borhencherni/Humanoid-Robotic-Arm/Mécanique/7.png

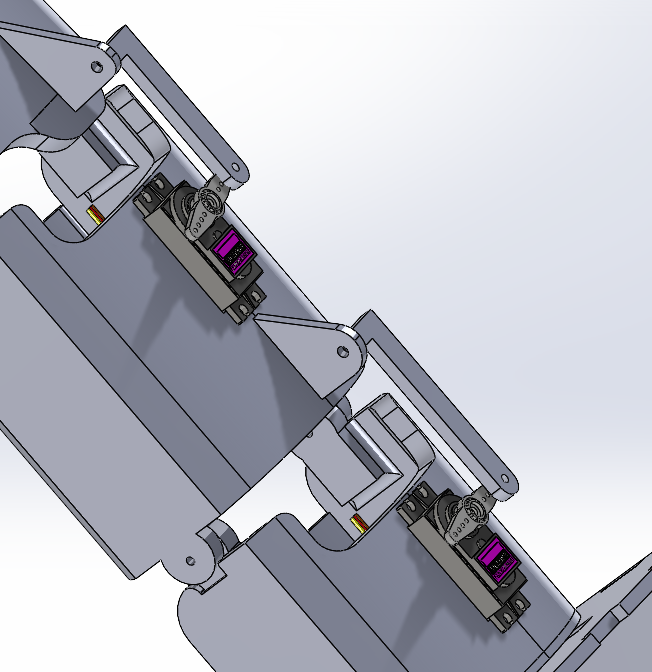
Mécanique/7.png
