borhencherni/Humanoid-Robotic-Arm/Mécanique/3.png

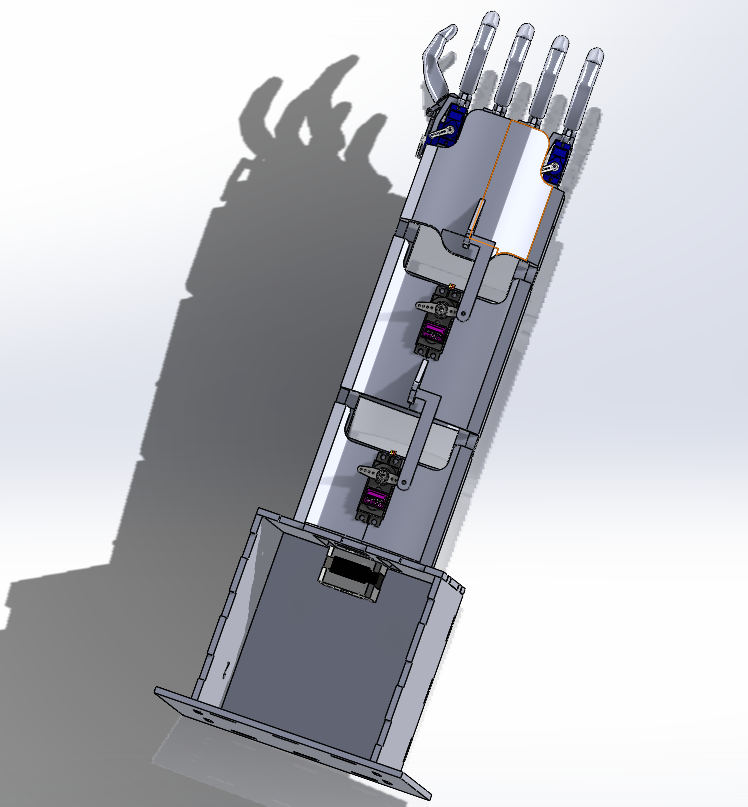
Mécanique/3.png
