borhencherni/Humanoid-Robotic-Arm/Electronique/4.png

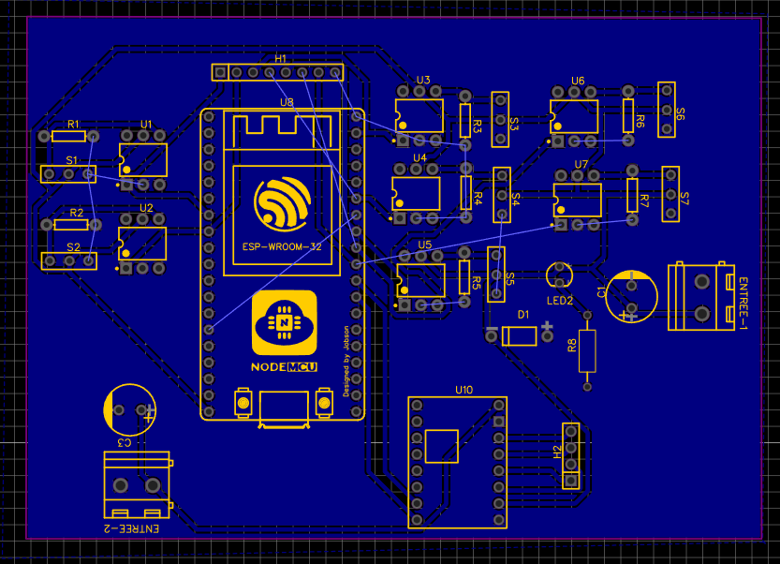
Electronique/4.png
