borhencherni/Humanoid-Robotic-Arm/Electronique/PCB_PCB_carte-ppp-finale_2025-05-31.png

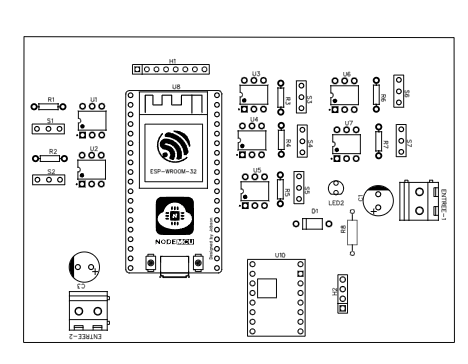
Electronique/PCB_PCB_carte-ppp-finale_2025-05-31.png
