borhencherni/Humanoid-Robotic-Arm/Mécanique/1.png

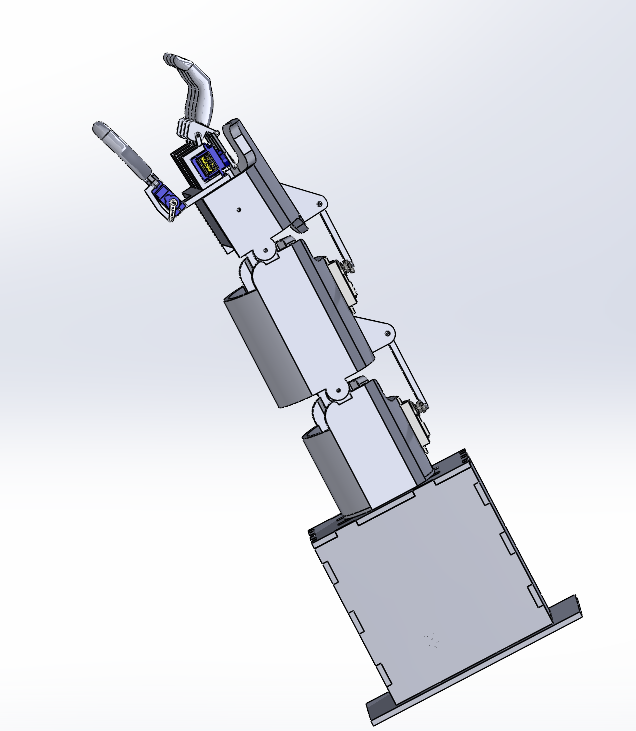
Mécanique/1.png
