borhencherni/Humanoid-Robotic-Arm/Mécanique/2.png

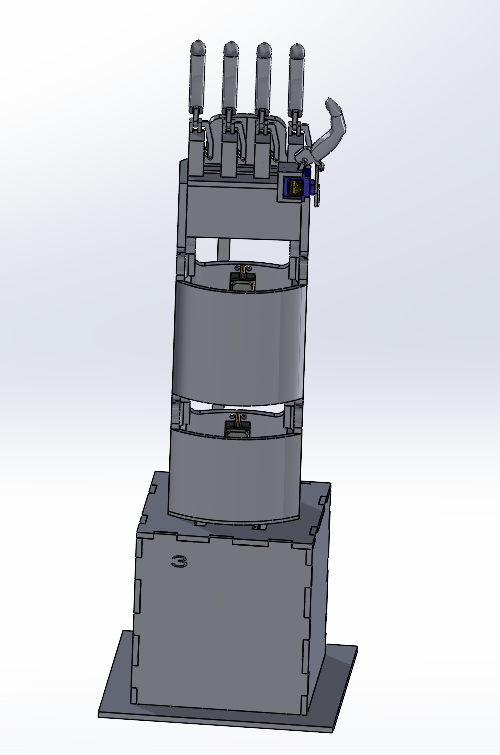
Mécanique/2.png
