borhencherni/Humanoid-Robotic-Arm/Mécanique/5.png

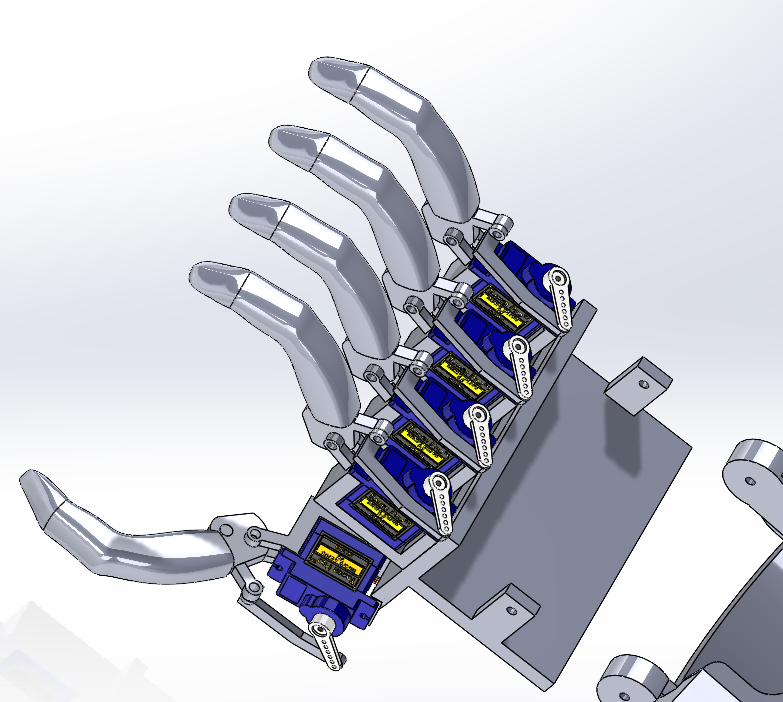
Mécanique/5.png
