borhencherni/Humanoid-Robotic-Arm/Mécanique/6.png

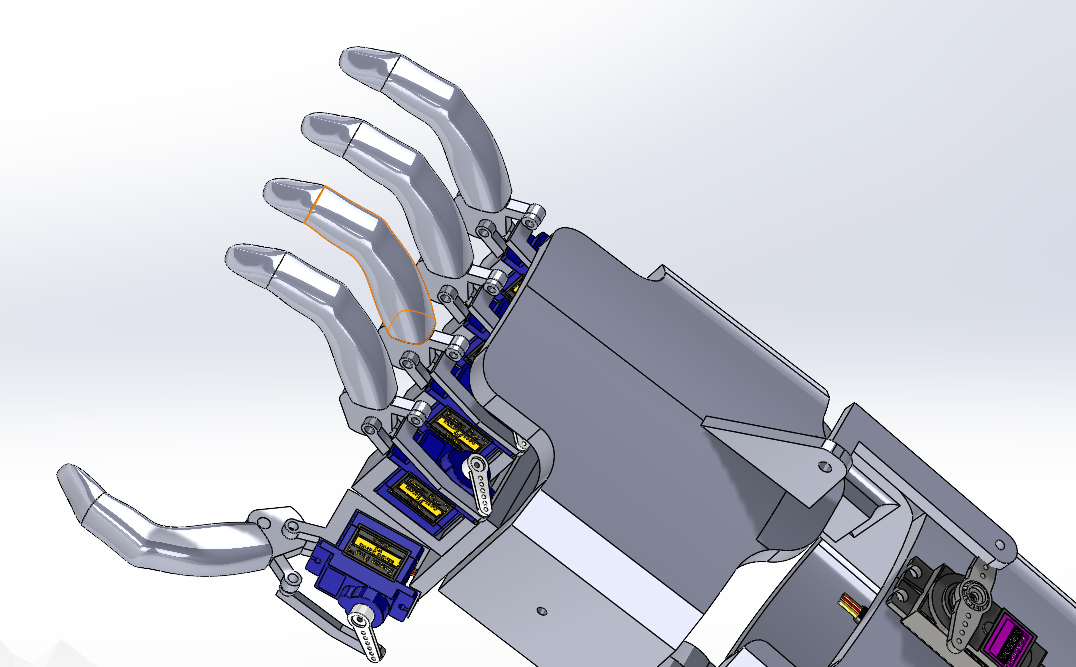
Mécanique/6.png
