borhencherni/Humanoid-Robotic-Arm/Mécanique/assemyed.SLDASM

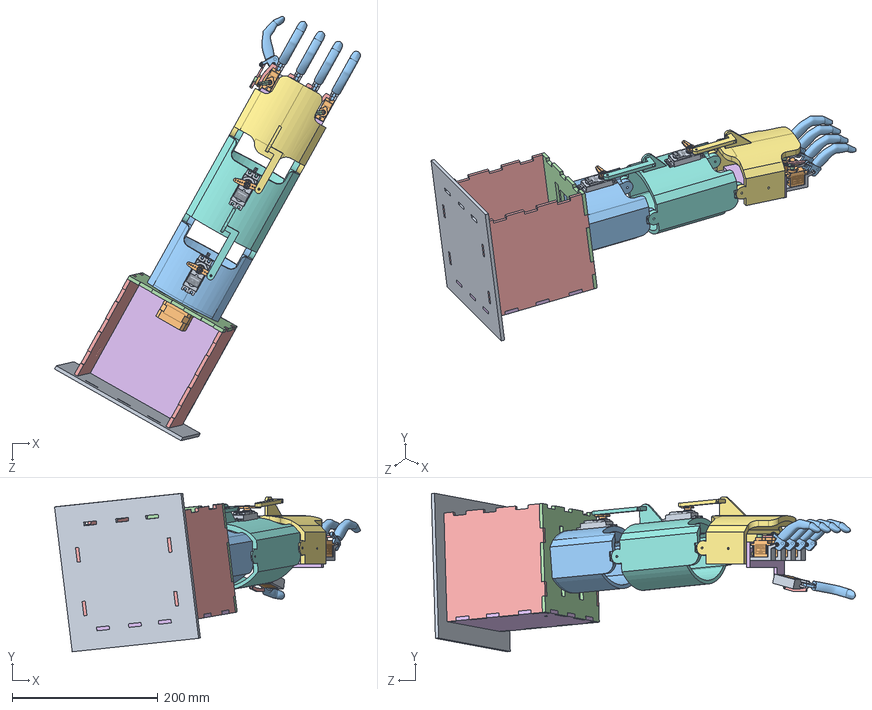
[picture p32: CAD file, 2025-06-15]
Mécanique/assemyed.SLDASM
419.3 x 217.3 x 581.5 mm
support servo x 5
SG90 - Micro Servo 9g - Tower Pro.1 x 5
sboo3 x 5
SG90 - Micro Servo 9g - Tower Pro.2 x 5
sbo3servo x 5
kaff
cagefou9
chtar yed
mg996R_v2.step x 2
mg996_arm_2pad.step x 2
chtar theni
liaison1
liaison2
Stepper motor Nema 17 (17HS2408).step
