borhencherni/Humanoid-Robotic-Arm/Mécanique/Assemsbo3.SLDASM

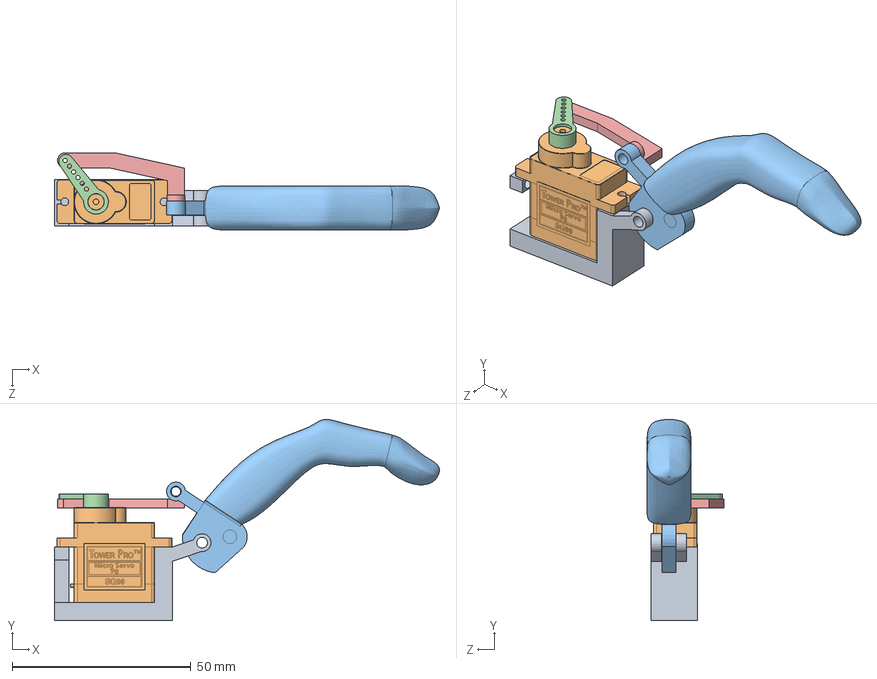
[picture p34: CAD file, 2025-06-15]
Mécanique/Assemsbo3.SLDASM
107.7 x 56.3 x 21.6 mm
support servo
SG90 - Micro Servo 9g - Tower Pro.1
sboo3
SG90 - Micro Servo 9g - Tower Pro.2
sbo3servo
