borhencherni/Humanoid-Robotic-Arm/Mécanique/mg996_arm_2pad.step

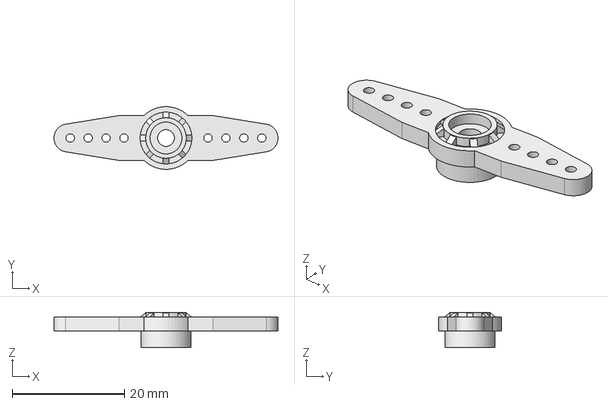
[picture p35: CAD file, 2025-06-15]
Mécanique/mg996_arm_2pad.step
40.0 x 11.2 x 6.30 mm
