borhencherni/Humanoid-Robotic-Arm/Mécanique/1.SLDPRT

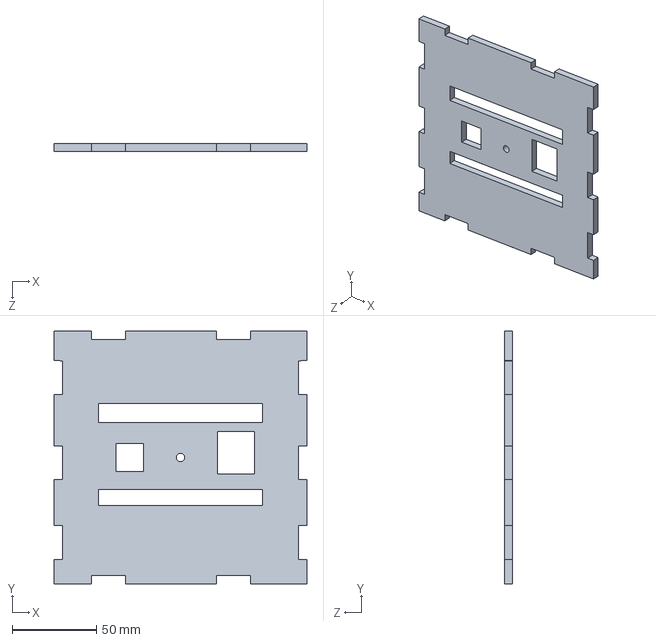
[picture p36: CAD file, 2025-06-15]
Mécanique/1.SLDPRT
150.0 x 150.0 x 5.00 mm
