borhencherni/Humanoid-Robotic-Arm/Mécanique/kaff.SLDPRT

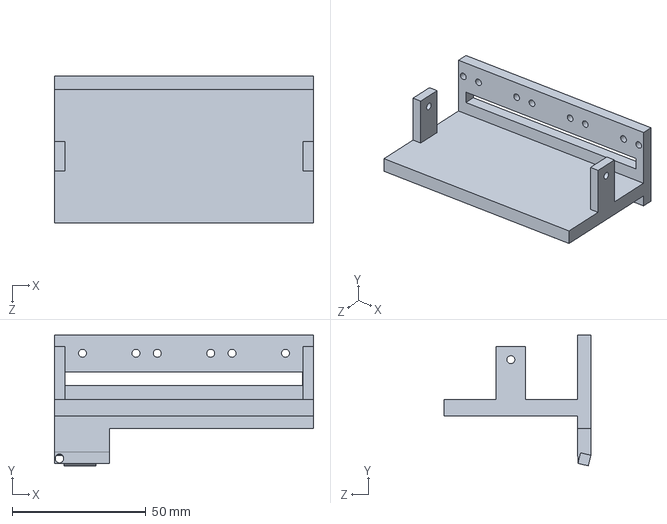
[picture p37: CAD file, 2025-06-15]
Mécanique/kaff.SLDPRT
97.0 x 49.0 x 55.0 mm
