borhencherni/Humanoid-Robotic-Arm/Mécanique/support servo.SLDPRT

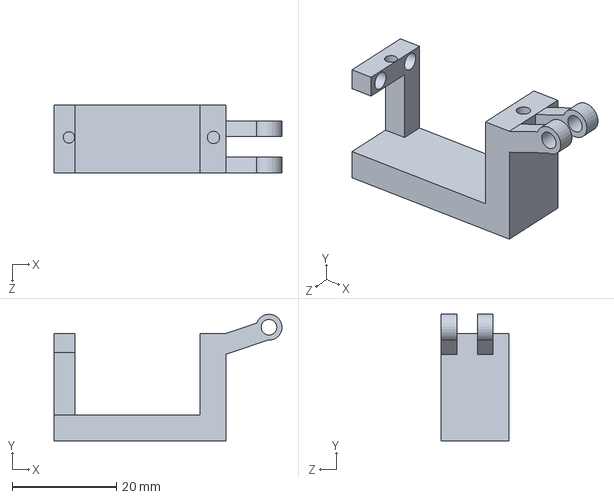
[picture p38: CAD file, 2025-06-15]
Mécanique/support servo.SLDPRT
43.8 x 24.3 x 13.0 mm
