borhencherni/Humanoid-Robotic-Arm/Mécanique/4.SLDPRT

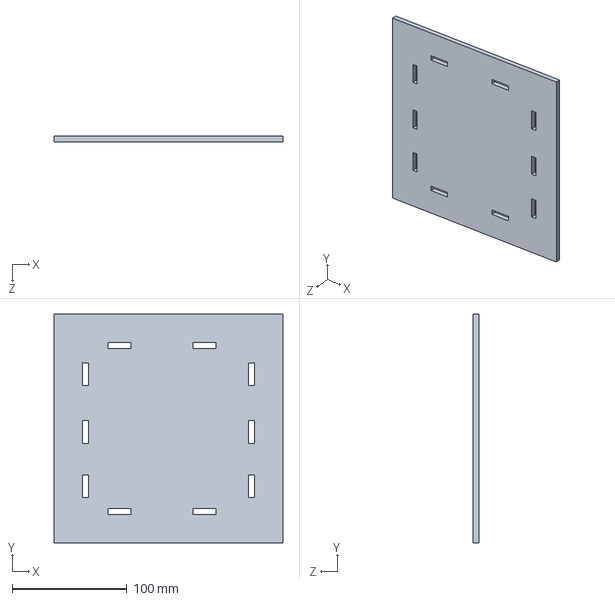
[picture p39: CAD file, 2025-06-15]
Mécanique/4.SLDPRT
200.0 x 200.0 x 5.00 mm
