borhencherni/Humanoid-Robotic-Arm/Mécanique/Stepper motor Nema 17 (17HS2408).STEP

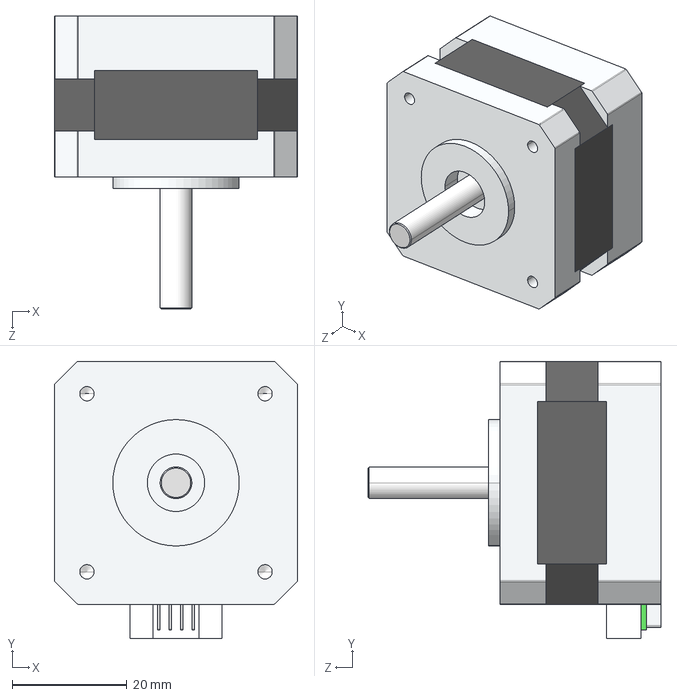
[picture p40: CAD file, 2025-06-15]
Mécanique/Stepper motor Nema 17 (17HS2408).STEP
42.3 x 48.3 x 51.0 mm
