borhencherni/Humanoid-Robotic-Arm/Mécanique/sboo3.SLDPRT

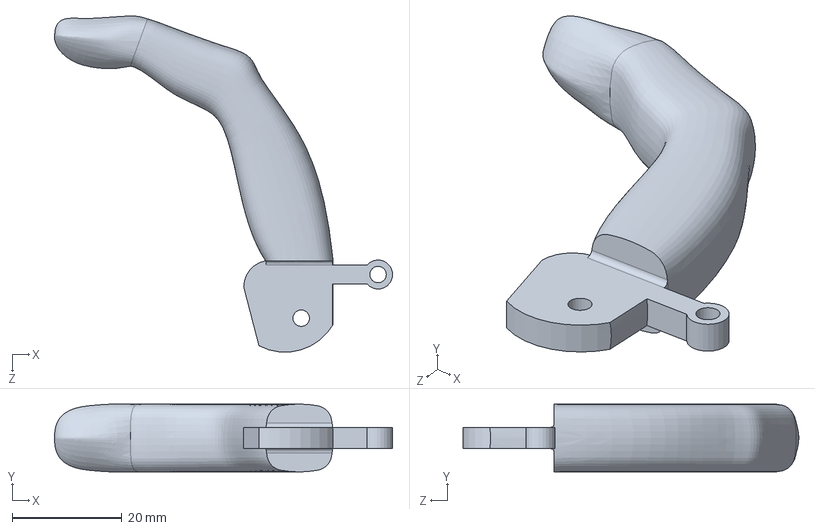
[picture p41: CAD file, 2025-06-15]
Mécanique/sboo3.SLDPRT
61.5 x 12.3 x 61.1 mm
