borhencherni/Humanoid-Robotic-Arm/Mécanique/chtar yed.SLDPRT

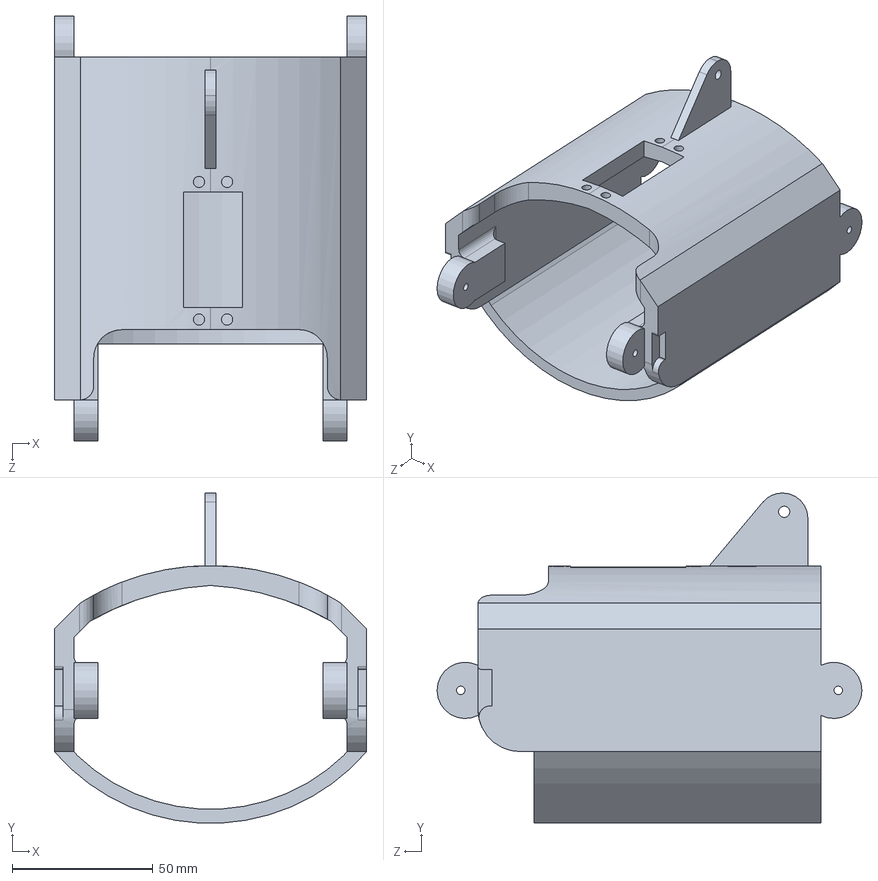
[picture p42: CAD file, 2025-06-15]
Mécanique/chtar yed.SLDPRT
111.0 x 117.3 x 151.0 mm
