borhencherni/Humanoid-Robotic-Arm/Mécanique/liaison1.SLDPRT

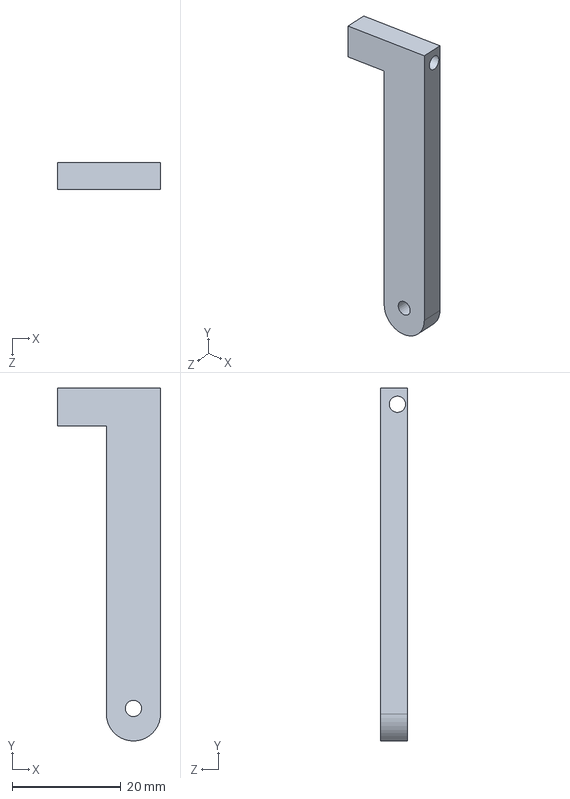
[picture p43: CAD file, 2025-06-15]
Mécanique/liaison1.SLDPRT
19.0 x 65.0 x 5.00 mm
