borhencherni/Humanoid-Robotic-Arm/Mécanique/cagefou9.SLDPRT

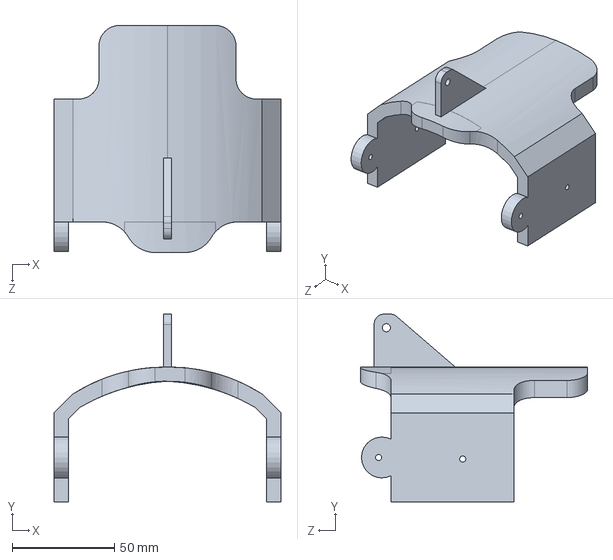
[picture p44: CAD file, 2025-06-15]
Mécanique/cagefou9.SLDPRT
111.0 x 91.9 x 111.0 mm
