borhencherni/Humanoid-Robotic-Arm/Mécanique/chtar theni.SLDPRT

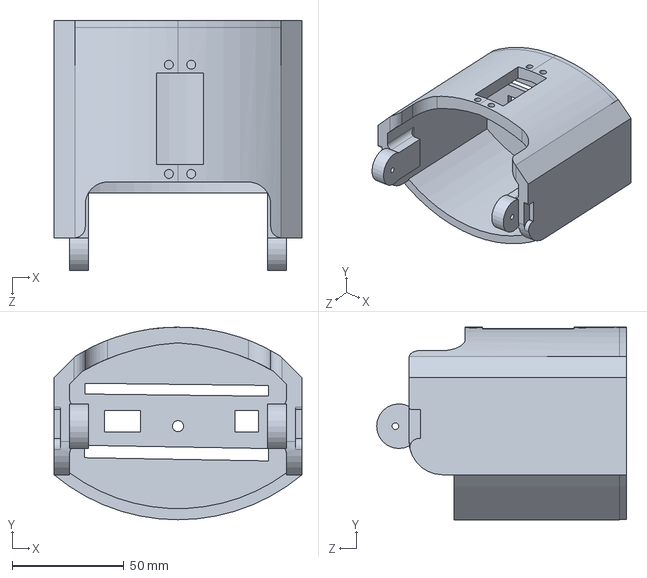
[picture p45: CAD file, 2025-06-15]
Mécanique/chtar theni.SLDPRT
111.0 x 86.2 x 111.8 mm
