borhencherni/Humanoid-Robotic-Arm/Mécanique/sbo3servo.SLDPRT

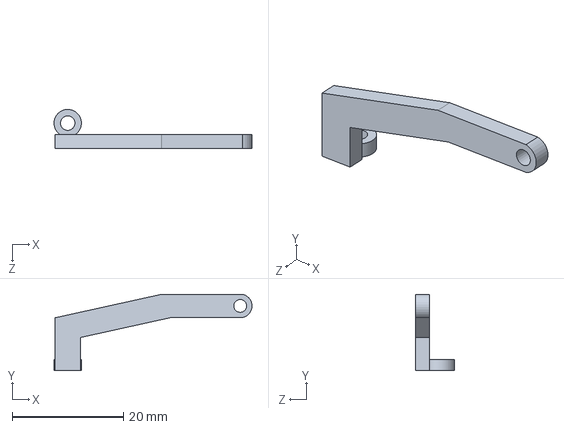
[picture p46: CAD file, 2025-06-15]
Mécanique/sbo3servo.SLDPRT
35.6 x 13.7 x 7.04 mm
