borhencherni/Humanoid-Robotic-Arm/Mécanique/3.SLDPRT

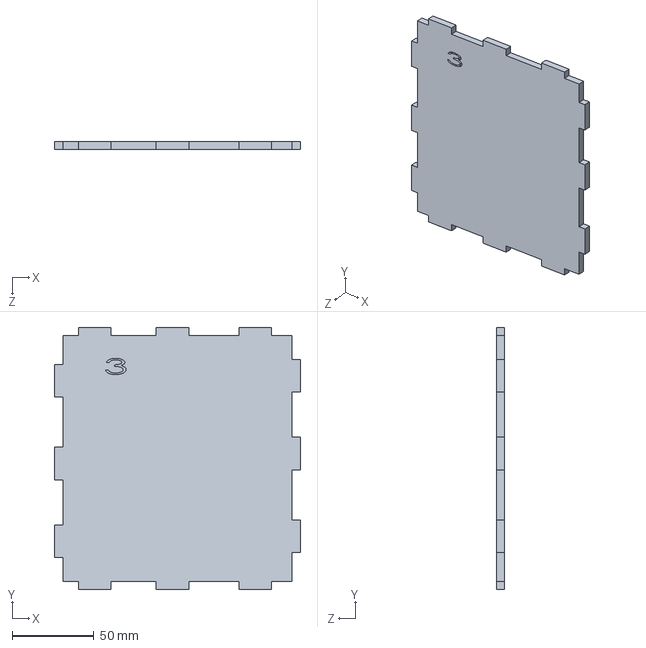
[picture p47: CAD file, 2025-06-15]
Mécanique/3.SLDPRT
150.2 x 160.0 x 5.00 mm
