borhencherni/Humanoid-Robotic-Arm/Mécanique/liaison2.SLDPRT

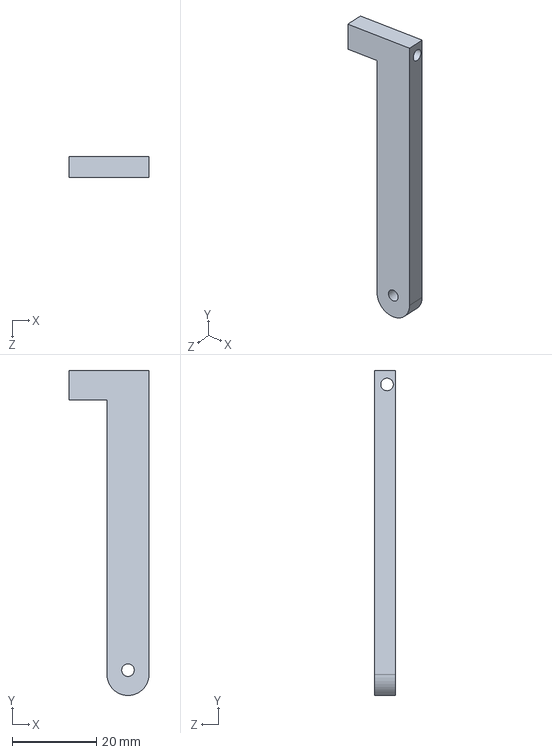
[picture p48: CAD file, 2025-06-15]
Mécanique/liaison2.SLDPRT
19.0 x 77.0 x 5.00 mm
