borhencherni/Humanoid-Robotic-Arm/(list of files, cad)

Other CAD files:
Mécanique/2.SLDPRT
