borhencherni/Humanoid-Robotic-Arm/Electronique/Schematic_carte-ppp_2025-06-03.pdf

5V 19 CLK 20 SD0 21 SD1 22 P15 23 P2 24 P0 25 P4 26 P16 27 P17 28 P5 29 P18 30 P19 31 GND 32 P21 33 RX 34 TX 35 P22 36 P23 37 GND 38

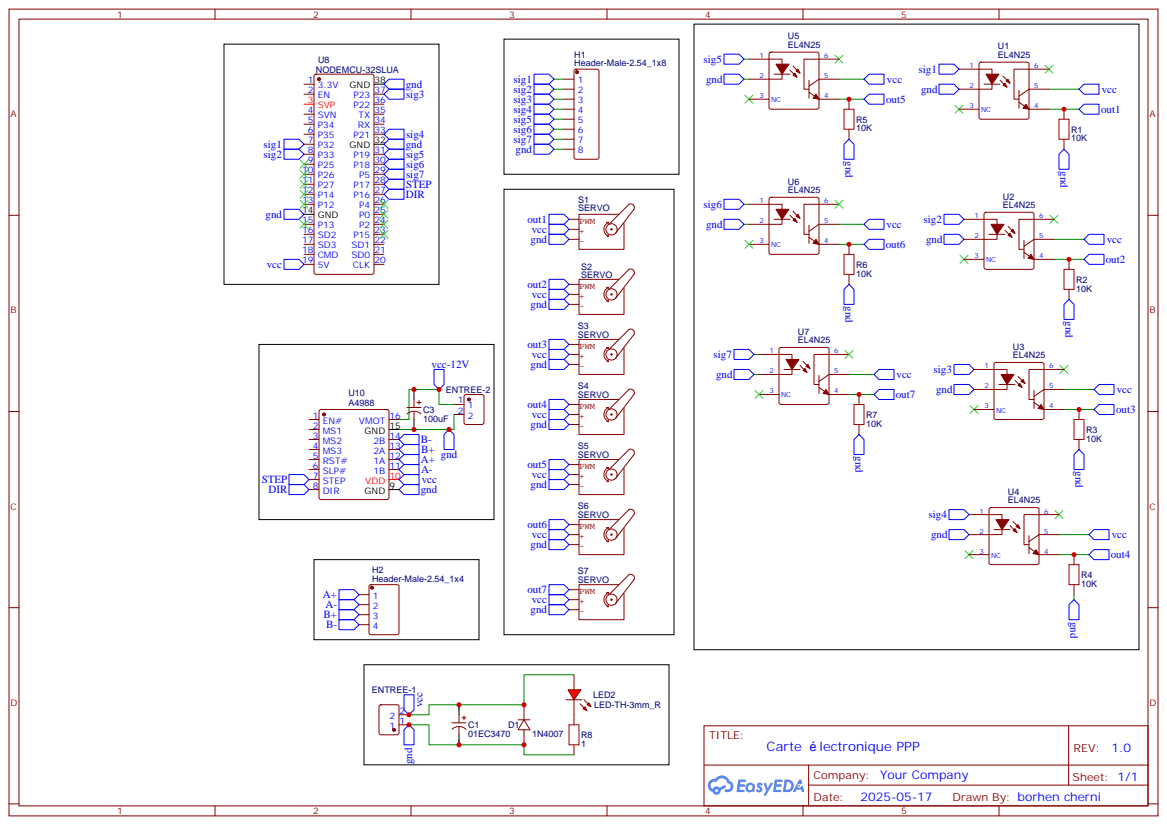
[picture p49: page 1]

Drawn By: borhen cherni
