borhencherni/Humanoid-Robotic-Arm/Electronique/PCB_PCB_carte-ppp-finale_2025-06-03.pdf

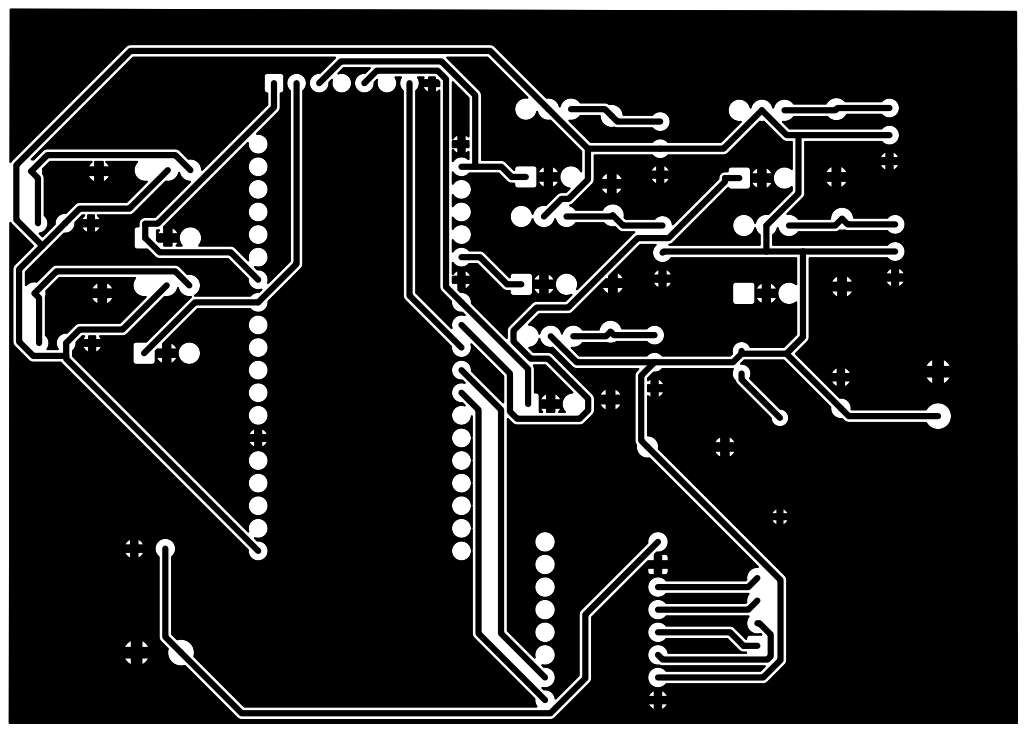
[picture p50: page 1]
